Tinkerforge/real-time-clock-bricklet/software/examples/labview/Example Callback.vi.png

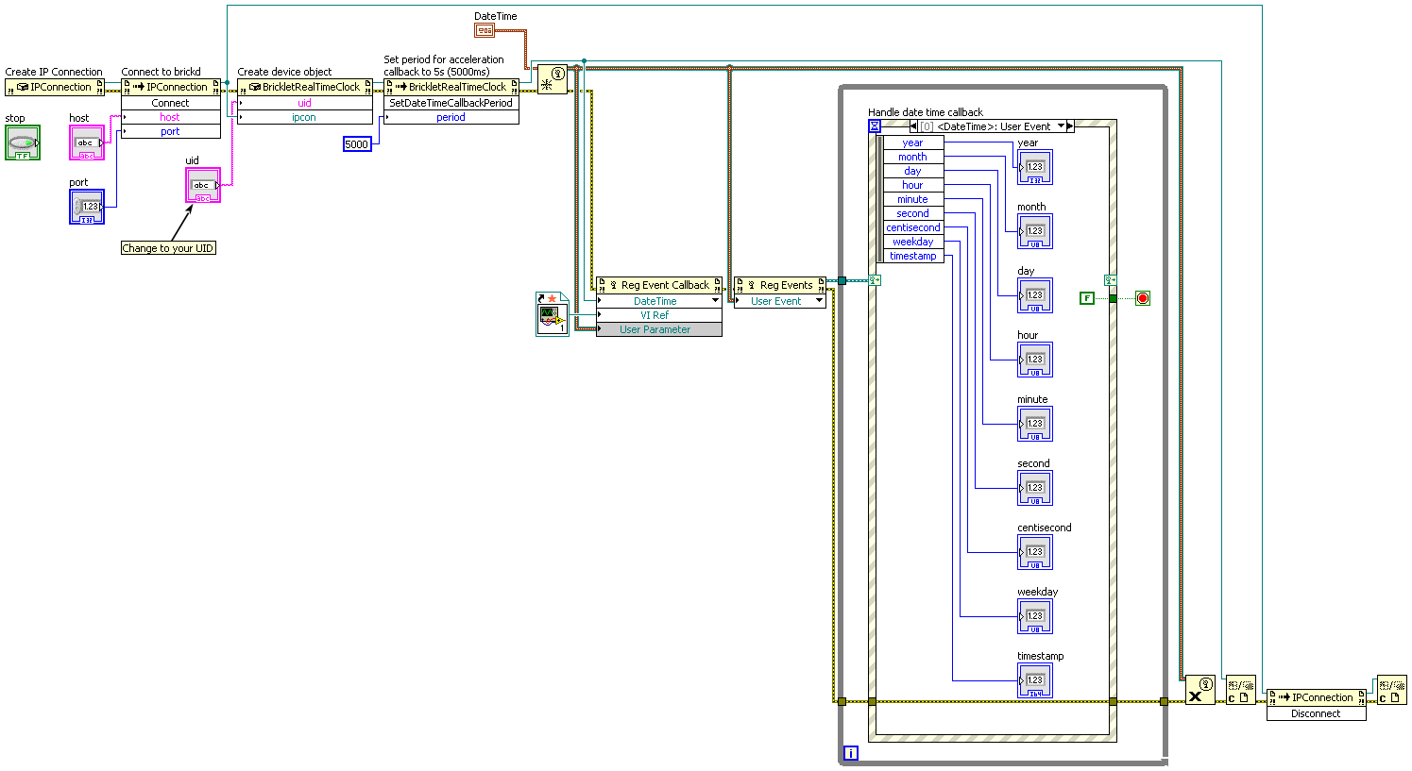
software/examples/labview/Example Callback.vi.png
