Tinkerforge/real-time-clock-bricklet/hardware/real-time-clock.step

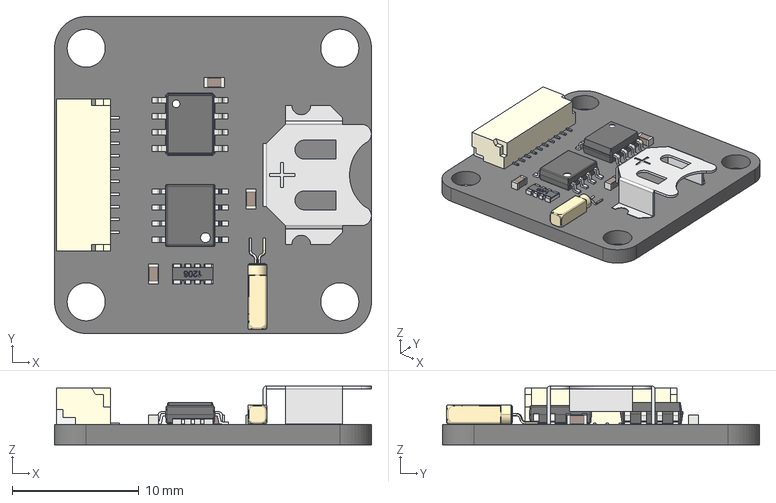
[picture p3: CAD file, 2018-01-30]
hardware/real-time-clock.step
25.0 x 25.0 x 4.65 mm
