Tinkerforge/real-time-clock-bricklet/(list of files, cad)

Other CAD files:
hardware/real-time-clock.FCStd
