Tinkerforge/real-time-clock-bricklet/hardware/real-time-clock-schematic.pdf

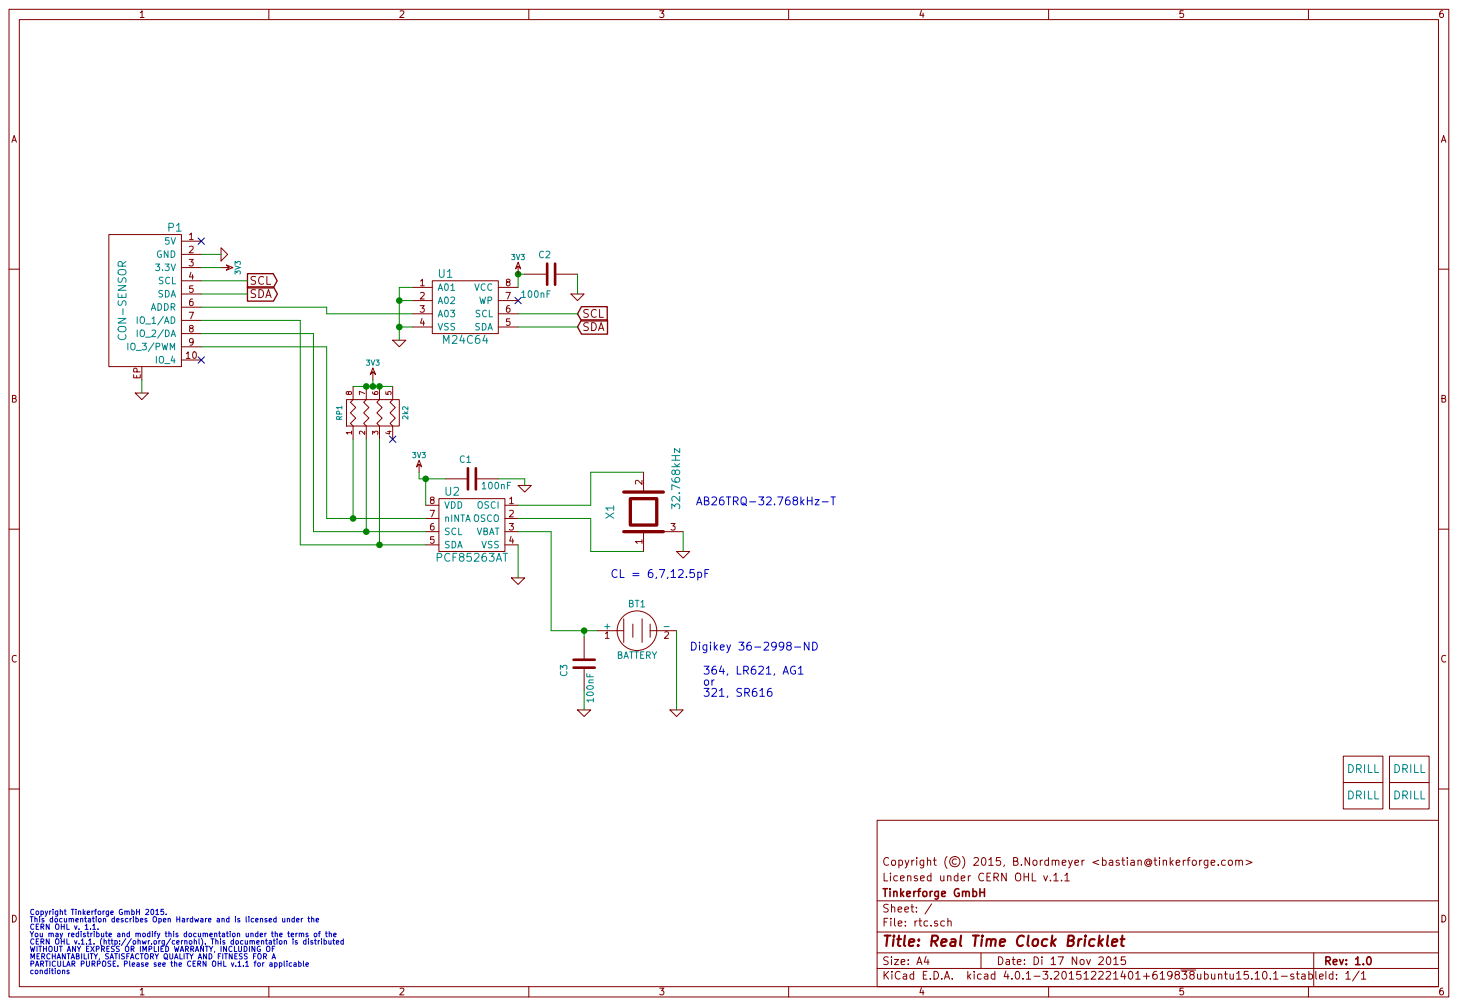
[picture p4: page 1]

Licensed under CERN OHL v.1.1 Copyright (©) 2015, B.Nordmeyer <bastian@tinkerforge.com>

Id: 1/1 Title: Real Time Clock Bricklet File: rtc.sch Sheet: / Tinkerforge GmbH

Copyright Tinkerforge GmbH 2015. This documentation describes Open Hardware and is licensed under the CERN OHL v. 1.1. You may redistribute and modify this documentation under the terms of the CERN OHL v.1.1. (http://ohwr.org/cernohl). This documentation is distributed WITHOUT ANY EXPRESS OR IMPLIED WARRANTY, INCLUDING OF MERCHANTABILITY, SATISFACTORY QUALITY AND FITNESS FOR A

PARTICULAR PURPOSE. Please see the CERN OHL v.1.1 for applicable
