Tinkerforge/real-time-clock-bricklet/hardware/real-time-clock.kicad_pcb

## KiCad design hardware/real-time-clock.kicad_pcb (2018-01-30)

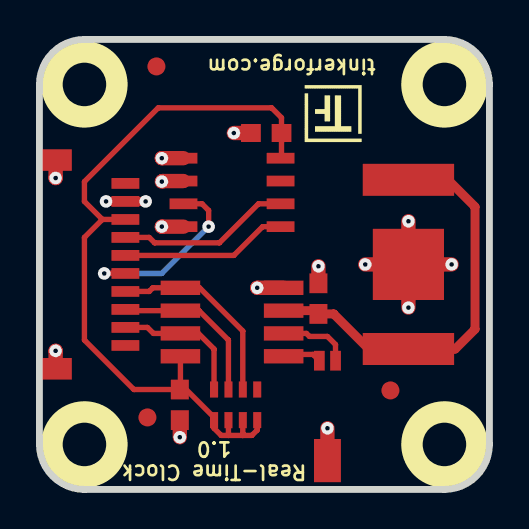
[picture p5: board real-time-clock.kicad_pcb from above]

Board: 2 copper layers, 25.0 x 25.0 mm, 18 parts (0 on the bottom side), 11 nets.

Parts:
BT1: BATTERY; BATTERY_HOLDER_2998
C1, C2, C3: 100nF; C0603E
Fiducial_Mark: VAL**; Fiducial_Mark
Fiducial_Mark#2, Fiducial_Mark#3: VAL**; Fiducial_Mark
P1: CON-SENSOR
RP1: 2k2; 4X0603
U1: M24C64; SOIC8
U2: PCF85263AT; SO-8
U3, U4, U5, U6: DRILL; DRILL_NP
VAL: WEEE_7mm_back
VAL#2: CE_5mm
X1: 32.768kHz; AB26TRQ

Connections:
3V3: C1.1, C2.1, P1.3, RP1.5, RP1.6, RP1.7, RP1.8, U1.8, U2.8
GND: BT1.2, C1.2, C2.2, C3.2, P1.2, P1.EP, U1.1, U1.2, U1.4, U2.4, X1.3
unnamed: BT1.1, C3.1, U2.3
unnamed: P1.6, U1.3
unnamed: P1.7, RP1.3, U2.5
unnamed: P1.8, RP1.2, U2.6
unnamed: P1.9, RP1.1, U2.7
unnamed: U2.1, X1.2
unnamed: U2.2, X1.1
SCL: P1.4, U1.6
SDA: P1.5, U1.5
