Tinkerforge/real-time-clock-bricklet/software/src/real-time-clock.c

/* real-time-clock
 * Copyright (C) 2016 Matthias Bolte <matthias@tinkerforge.com>
 *
 * real-time-clock.c: Implementation of Real Time Clock Bricklet messages
 *
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
 * You should have received a copy of the GNU Lesser General Public
 * License along with this library; if not, write to the
 * Free Software Foundation, Inc., 59 Temple Place - Suite 330,
 * Boston, MA 02111-1307, USA.
 */

#include "real-time-clock.h"

#include "brickletlib/bricklet_entry.h"
#include "bricklib/bricklet/bricklet_communication.h"
#include "config.h"
#include "bricklib/utility/util_definitions.h"

#define I2C_ADDRESS 0x51 // 0b1010001, I2C address of PCF85263A
#define I2C_HALF_CLOCK_400KHZ 1250 // 2500ns per clock
#define I2C_READ 1
#define I2C_WRITE 0

void invocation(const ComType com, const uint8_t *data) {
	switch(((MessageHeader*)data)->fid) {
		case FID_SET_DATE_TIME:
			set_date_time(com, (SetDateTime*)data);
			return;

		case FID_GET_DATE_TIME:
			get_date_time(com, (GetDateTime*)data);
			return;

		case FID_GET_TIMESTAMP:
			get_timestamp(com, (GetTimestamp*)data);
			return;

		case FID_SET_OFFSET:
			set_offset(com, (SetOffset*)data);
			return;

		case FID_GET_OFFSET:
			get_offset(com, (GetOffset*)data);
			return;

		case FID_SET_DATE_TIME_CALLBACK_PERIOD:
			set_date_time_callback_period(com, (SetDateTimeCallbackPeriod*)data);
			return;

		case FID_GET_DATE_TIME_CALLBACK_PERIOD:
			get_date_time_callback_period(com, (GetDateTimeCallbackPeriod*)data);
			return;

		case FID_SET_ALARM:
			set_alarm(com, (SetAlarm*)data);
			return;

		case FID_GET_ALARM:
			get_alarm(com, (GetAlarm*)data);
			return;

		default:
			BA->com_return_error(data, sizeof(MessageHeader), MESSAGE_ERROR_CODE_NOT_SUPPORTED, com);
			return;
	}
}

void constructor(void) {
	_Static_assert(sizeof(BrickContext) <= BRICKLET_CONTEXT_MAX_SIZE, "BrickContext too big");

	BrickletAPI *ba = BA;
	BrickContext *bc = BC;

	bc->period_date_time = 0;
	bc->period_date_time_counter = 0;
	bc->last_date_time_valid = false;

	bc->flags = 0;
	bc->alarm_enable = 0;
	bc->interval = -1;

	// Setting the interrupt pin as input
	PIN_INT.pio->PIO_PUER = PIN_INT.mask;
	PIN_INT.pio->PIO_ODR = PIN_INT.mask;
	PIN_INT.pio->PIO_PER = PIN_INT.mask;

	// Load calibration from EEPROM
	ba->bricklet_select(BS->port - 'a');

	ba->i2c_eeprom_master_read(ba->twid->pTwi,
	                           CALIBRATION_EEPROM_POSITION,
	                           (char *)bc->calibration,
	                           sizeof(bc->calibration));

	if (bc->calibration[0] == CALIBRATION_EEPROM_MAGIC0 &&
	    bc->calibration[1] == CALIBRATION_EEPROM_MAGIC1) {
		write_register(REG_OFFSET, bc->calibration[2]);
	} else {
		// EEPROM doesn't contain calibration, store current calibration
		bc->calibration[0] = CALIBRATION_EEPROM_MAGIC0;
		bc->calibration[1] = CALIBRATION_EEPROM_MAGIC1;
		bc->calibration[2] = read_register(REG_OFFSET);

		ba->i2c_eeprom_master_write(ba->twid->pTwi,
		                            CALIBRATION_EEPROM_POSITION,
		                            (const char*)bc->calibration,
		                            sizeof(bc->calibration));
	}

	ba->bricklet_deselect(BS->port - 'a');

	// Select 12.5pF oscillator load capacitance
	write_register(REG_OSCILLATOR, REG_OSCILLATOR_CL_12PF);

	// Enable 100th second and set CLK pin frequency to 0Hz
	write_register(REG_FUNCTION, REG_FUNCTION_100TH_ENABLED | REG_FUNCTION_COF_STATIC_LOW);

	// Disable CLK pin and enable nINTA output pin
	write_register(REG_PIN_IO, REG_PIN_IO_CLKPM_DISABLE | REG_PIN_IO_INTAPM_INTA);

	// Enable nINTA interrupts
	write_register(REG_INTA_ENABLE, REG_INTA_ENABLE_ALARM1 | REG_INTA_ENABLE_ALARM2 | REG_INTA_ENABLE_LEVEL_MODE);
}

void destructor(void) {
}

void tick(const uint8_t tick_type) {
	BrickletAPI *ba = BA;
	BrickContext *bc = BC;
	uint32_t uid = BS->uid;

	if (tick_type & TICK_TASK_TYPE_CALCULATION) {
		if (!(PIN_INT.pio->PIO_PDSR & PIN_INT.mask)) { // nINTA
			bc->flags = read_register(REG_FLAGS);
			bc->alarm_enable = read_register(REG_RTC_ALARM_ENABLE);
			write_register(REG_FLAGS, 0);
		}

		if (bc->period_date_time_counter != 0) {
			bc->period_date_time_counter--;
		}
	}

	if (tick_type & TICK_TASK_TYPE_MESSAGE) {
		if (bc->period_date_time != 0 && bc->period_date_time_counter == 0) {
			DateTime dt;
			ba->com_make_default_header(&dt, uid, sizeof(dt), FID_DATE_TIME);

			uint64_t registers_merged = read_date_time(&dt.fields);

			if (!bc->last_date_time_valid || bc->last_date_time_merged != registers_merged) {
				dt.timestamp = calculate_timestamp(&dt.fields);

				ba->send_blocking_with_timeout(&dt, sizeof(dt), *ba->com_current);

				bc->period_date_time_counter = bc->period_date_time;

				bc->last_date_time_valid = true;
				bc->last_date_time_merged = registers_merged;
			}
		}

		if (bc->flags & (REG_FLAGS_ALARM1 | REG_FLAGS_ALARM2)) {
			uint8_t expected = 0;
			uint8_t found = 0;

			if (bc->alarm_enable & REG_RTC_ALARM_ENABLE_A1E_mask) {
				++expected;

				if (bc->flags & REG_FLAGS_ALARM1) {
					++found;
				}
			}

			if (bc->alarm_enable & REG_RTC_ALARM_ENABLE_A2E_mask) {
				++expected;

				if (bc->flags & REG_FLAGS_ALARM2) {
					++found;
				}
			}

			bool triggered = false;

			if (expected > 0) {
				if (expected == found) {
					triggered = true;
				} else if (expected == 2 && (bc->flags & REG_FLAGS_ALARM1)) {
					// Special case: weekday + other fields are enabled and the
					// other fields have triggered, but the weekday had already
					// triggered before or not at all. Manually check if the
					// weekday still matches to manually trigger the alarm.
					uint8_t alarm_weekday = read_register(REG_RTC_ALARM2_WEEKDAY);
					uint8_t date_weekday = read_register(REG_RTC_DATE_WEEKDAY);

					if (alarm_weekday == date_weekday) {
						triggered = true;
					}
				}
			}

			if (triggered) {
				Alarm a;
				ba->com_make_default_header(&a, uid, sizeof(a), FID_ALARM);

				read_date_time(&a.fields);
				a.timestamp = calculate_timestamp(&a.fields);

				if (bc->interval > 0) {
					DateTimeFields fields = a.fields;
					uint8_t bytes[9];

					// Clear alarm enable bits
					write_register(REG_RTC_ALARM_ENABLE, 0);

					// Calculate new alarm
					if (add_seconds(&fields, bc->interval)) {
						bytes[0] = bin2bcd(fields.second);
						bytes[1] = bin2bcd(fields.minute);
						bytes[2] = bin2bcd(fields.hour);
						bytes[3] = bin2bcd(fields.day);
						bytes[4] = bin2bcd(fields.month);

						bytes[8] = REG_RTC_ALARM_ENABLE_A1E_MONTH |
						           REG_RTC_ALARM_ENABLE_A1E_DAY |
						           REG_RTC_ALARM_ENABLE_A1E_HOUR |
						           REG_RTC_ALARM_ENABLE_A1E_MINUTE |
						           REG_RTC_ALARM_ENABLE_A1E_SECOND;

						// Set alarm and enable bits
						write_registers(REG_RTC_ALARM1_SECOND, bytes, 9);
					}
				}

				ba->send_blocking_with_timeout(&a, sizeof(a), *ba->com_current);
			}

			bc->flags = 0;
			bc->alarm_enable = 0;
		}
	}
}

void set_date_time(const ComType com, const SetDateTime *data) {
	BrickletAPI *ba = BA;

	if (data->year < 2000 || data->year > 2099 ||
	    data->month < 1 || data->month > 12 ||
	    data->day < 1 || data->day > 31 ||
	    data->hour > 23 ||
	    data->minute > 59 ||
	    data->second > 59 ||
	    data->centisecond > 99 ||
	    data->weekday < 1 || data->weekday > 7) {
		ba->com_return_error(data, sizeof(MessageHeader), MESSAGE_ERROR_CODE_INVALID_PARAMETER, com);
		return;
	}

	const uint8_t bytes[8] = {
		bin2bcd(data->centisecond),
		bin2bcd(data->second),
		bin2bcd(data->minute),
		bin2bcd(data->hour),
		bin2bcd(data->day),
		bin2bcd(data->weekday % 7), // Convert from [Mon..Sun] == [1..7] to [Sun..Sat] == [0..6]
		bin2bcd(data->month),
		bin2bcd(data->year - 2000)
	};

	// Stop clock and clear prescaler
	write_register(REG_STOP_ENABLE, REG_STOP_ENABLE_STOP_ENABLED);
	write_register(REG_RESET, REG_RESET_CLEAR_PRESCALER);

	// Set clock
	write_registers(REG_RTC_TIME_100TH_SECOND, bytes, 8);

	// Start clock
	write_register(REG_STOP_ENABLE, REG_STOP_ENABLE_STOP_DISABLED);

	ba->com_return_setter(com, data);
}

void get_date_time(const ComType com, const GetDateTime *data) {
	GetDateTimeReturn gdtr;

	gdtr.header        = data->header;
	gdtr.header.length = sizeof(gdtr);

	read_date_time(&gdtr.fields);

	BA->send_blocking_with_timeout(&gdtr, sizeof(gdtr), com);
}

void get_timestamp(const ComType com, const GetTimestamp *data) {
	GetTimestampReturn gtr;
	DateTimeFields fields;

	gtr.header        = data->header;
	gtr.header.length = sizeof(gtr);

	read_date_time(&fields);

	gtr.timestamp     = calculate_timestamp(&fields);

	BA->send_blocking_with_timeout(&gtr, sizeof(gtr), com);
}

void set_offset(const ComType com, const SetOffset *data) {
	BrickletAPI *ba = BA;
	BrickContext *bc = BC;

	bc->calibration[2] = data->offset;

	write_register(REG_OFFSET, bc->calibration[2]);

	ba->bricklet_select(BS->port - 'a');
	ba->i2c_eeprom_master_write(ba->twid->pTwi,
	                            CALIBRATION_EEPROM_POSITION,
	                            (const char*)bc->calibration,
	                            sizeof(bc->calibration));
	ba->bricklet_deselect(BS->port - 'a');

	ba->com_return_setter(com, data);
}

void get_offset(const ComType com, const GetOffset *data) {
	GetOffsetReturn gor;

	gor.header        = data->header;
	gor.header.length = sizeof(gor);
	gor.offset        = BC->calibration[2];

	BA->send_blocking_with_timeout(&gor, sizeof(gor), com);
}

void set_date_time_callback_period(const ComType com, const SetDateTimeCallbackPeriod *data) {
	BC->period_date_time = data->period;

	BA->com_return_setter(com, data);
}

void get_date_time_callback_period(const ComType com, const GetDateTimeCallbackPeriod *data) {
	GetDateTimeCallbackPeriodReturn gdtcpr;

	gdtcpr.header         = data->header;
	gdtcpr.header.length  = sizeof(gdtcpr);
	gdtcpr.period         = BC->period_date_time;

	BA->send_blocking_with_timeout(&gdtcpr, sizeof(gdtcpr), com);
}

void set_alarm(const ComType com, const SetAlarm *data) {
	BrickletAPI *ba = BA;

#if 0
	// FIXME: this would be the classic way of parameter checking, but with
	//        this GCC misscompiles the code. therefore, parameter checking is
	//        integrated with the parameter translation
	if ((data->month != -1 && (data->month < 1 || data->month > 12)) ||
	    (data->day != -1 && (data->day < 1 || data->day > 31)) ||
	    (data->hour != -1 && (data->hour < 0 || data->hour > 23)) ||
	    (data->minute != -1 && (data->minute < 0 || data->minute > 59)) ||
	    (data->second != -1 && (data->second < 0 || data->second > 59)) ||
	    (data->weekday != -1 && (data->weekday < 1 || data->weekday > 7)) ||
	    (data->interval != -1 && data->interval == 0) {
		ba->com_return_error(data, sizeof(MessageHeader), MESSAGE_ERROR_CODE_INVALID_PARAMETER, com);
		return;
	}
#endif

	// Prepare alarm register values
	uint8_t bytes[9] = {0};
	bool invalid = false;

	if (data->second >= 0 && data->second <= 59) {
		bytes[0] = bin2bcd(data->second);
		bytes[8] |= REG_RTC_ALARM_ENABLE_A1E_SECOND;
	} else if (data->second != -1) {
		invalid = true;
	}

	if (data->minute >= 0 && data->minute <= 59) {
		bytes[1] = bin2bcd(data->minute);
		bytes[8] |= REG_RTC_ALARM_ENABLE_A1E_MINUTE;
	} else if (data->minute != -1) {
		invalid = true;
	}

	if (data->hour >= 0 && data->hour <= 23) {
		bytes[2] = bin2bcd(data->hour);
		bytes[8] |= REG_RTC_ALARM_ENABLE_A1E_HOUR;
	} else if (data->hour != -1) {
		invalid = true;
	}

	if (data->day >= 1 && data->day <= 31) {
		bytes[3] = bin2bcd(data->day);
		bytes[8] |= REG_RTC_ALARM_ENABLE_A1E_DAY;
	} else if (data->day != -1) {
		invalid = true;
	}

	if (data->month >= 1 && data->month <= 12) {
		bytes[4] = bin2bcd(data->month);
		bytes[8] |= REG_RTC_ALARM_ENABLE_A1E_MONTH;
	} else if (data->month != -1) {
		invalid = true;
	}

	if (data->weekday >= 1 && data->weekday <= 7) {
		bytes[7] = bin2bcd(data->weekday % 7), // Convert from [Mon..Sun] == [1..7] to [Sun..Sat] == [0..6]
		bytes[8] |= REG_RTC_ALARM_ENABLE_A2E_WEEKDAY;
	} else if (data->weekday != -1) {
		invalid = true;
	}

	if (data->interval == 0 || data->interval < -1) {
		invalid = true;
	}

	if (invalid) {
		ba->com_return_error(data, sizeof(MessageHeader), MESSAGE_ERROR_CODE_INVALID_PARAMETER, com);
		return;
	}

	BC->interval = data->interval;

	if (bytes[8] == 0 && data->interval > 0) {
		DateTimeFields fields;

		read_date_time(&fields);

		if (add_seconds(&fields, data->interval)) {
			bytes[0] = bin2bcd(fields.second);
			bytes[1] = bin2bcd(fields.minute);
			bytes[2] = bin2bcd(fields.hour);
			bytes[3] = bin2bcd(fields.day);
			bytes[4] = bin2bcd(fields.month);

			bytes[8] = REG_RTC_ALARM_ENABLE_A1E_MONTH |
			           REG_RTC_ALARM_ENABLE_A1E_DAY |
			           REG_RTC_ALARM_ENABLE_A1E_HOUR |
			           REG_RTC_ALARM_ENABLE_A1E_MINUTE |
			           REG_RTC_ALARM_ENABLE_A1E_SECOND;
		} else {
			bytes[8] = 0;
		}
	}

	// Clear alarm enable bits
	write_register(REG_RTC_ALARM_ENABLE, 0);

	// Clear alarm interrupt flags
	write_register(REG_FLAGS, 0);

	// Set alarm and enable bits
	if (bytes[8] != 0) {
		write_registers(REG_RTC_ALARM1_SECOND, bytes, 9);
	}

	ba->com_return_setter(com, data);
}

void get_alarm(const ComType com, const GetAlarm *data) {
	GetAlarmReturn gar;
	uint8_t bytes[9];

	gar.header         = data->header;
	gar.header.length  = sizeof(gar);

	read_registers(REG_RTC_ALARM1_SECOND, bytes, 9);

	if (bytes[8] & REG_RTC_ALARM_ENABLE_A1E_MONTH) {
		gar.month = bcd2bin(bytes[4]);
	} else {
		gar.month = -1;
	}

	if (bytes[8] & REG_RTC_ALARM_ENABLE_A1E_DAY) {
		gar.day = bcd2bin(bytes[3]);
	} else {
		gar.day = -1;
	}

	if (bytes[8] & REG_RTC_ALARM_ENABLE_A1E_HOUR) {
		gar.hour = bcd2bin(bytes[2]);
	} else {
		gar.hour = -1;
	}

	if (bytes[8] & REG_RTC_ALARM_ENABLE_A1E_MINUTE) {
		gar.minute = bcd2bin(bytes[1]);
	} else {
		gar.minute = -1;
	}

	if (bytes[8] & REG_RTC_ALARM_ENABLE_A1E_SECOND) {
		gar.second = bcd2bin(bytes[0]);
	} else {
		gar.second = -1;
	}

	if (bytes[8] & REG_RTC_ALARM_ENABLE_A2E_WEEKDAY) {
		gar.weekday = bcd2bin(bytes[7]);

		// Convert from [Sun..Sat] == [0..6] to [Mon..Sun] == [1..7]
		if (gar.weekday == 0) {
			gar.weekday = 7;
		}
	} else {
		gar.weekday = -1;
	}

	gar.interval = BC->interval;

	BA->send_blocking_with_timeout(&gar, sizeof(gar), com);
}

uint8_t read_register(const uint8_t reg) {
	i2c_start();
	i2c_send_byte((I2C_ADDRESS << 1) | I2C_WRITE);
	i2c_send_byte(reg);
	i2c_stop();
	i2c_start();
	i2c_send_byte((I2C_ADDRESS << 1) | I2C_READ);

	uint8_t value = i2c_recv_byte(false);

	i2c_stop();

	return value;
}

void read_registers(const uint8_t reg, uint8_t *data, const uint8_t length) {
	i2c_start();
	i2c_send_byte((I2C_ADDRESS << 1) | I2C_WRITE);
	i2c_send_byte(reg);
	i2c_stop();
	i2c_start();
	i2c_send_byte((I2C_ADDRESS << 1) | I2C_READ);

	for(uint8_t i = 0; i < length; i++) {
		data[i] = i2c_recv_byte(i != (length - 1));
	}

	i2c_stop();
}

void write_register(const uint8_t reg, const uint8_t value) {
	i2c_start();
	i2c_send_byte((I2C_ADDRESS << 1) | I2C_WRITE);
	i2c_send_byte(reg);
	i2c_send_byte(value);
	i2c_stop();
}

void write_registers(const uint8_t reg, const uint8_t *data, const uint8_t length) {
	i2c_start();
	i2c_send_byte((I2C_ADDRESS << 1) | I2C_WRITE);
	i2c_send_byte(reg);

	for(uint8_t i = 0; i < length; i++) {
		i2c_send_byte(data[i]);
	}

	i2c_stop();
}

uint64_t read_date_time(DateTimeFields *fields) {
	union {
		uint8_t bytes[8];
		uint64_t merged;
	} data;

	read_registers(REG_RTC_TIME_100TH_SECOND, data.bytes, 8);

	data.bytes[2] &= 0b01111111; // remove EMON bit
	data.bytes[1] &= 0b01111111; // remove OS bit

	fields->year        = 2000 + bcd2bin(data.bytes[7]);
	fields->month       = bcd2bin(data.bytes[6]);
	fields->day         = bcd2bin(data.bytes[4]);
	fields->hour        = bcd2bin(data.bytes[3]);
	fields->minute      = bcd2bin(data.bytes[2]);
	fields->second      = bcd2bin(data.bytes[1]);
	fields->centisecond = bcd2bin(data.bytes[0]);
	fields->weekday     = bcd2bin(data.bytes[5]);

	// Convert from [Sun..Sat] == [0..6] to [Mon..Sun] == [1..7]
	if (fields->weekday == 0) {
		fields->weekday = 7;
	}

	return data.merged;
}

static const uint16_t days_before_this_month_table[12] = {
	0,
	31,
	31 + 28,
	31 + 28 + 31,
	31 + 28 + 31 + 30,
	31 + 28 + 31 + 30 + 31,
	31 + 28 + 31 + 30 + 31 + 30,
	31 + 28 + 31 + 30 + 31 + 30 + 31,
	31 + 28 + 31 + 30 + 31 + 30 + 31 + 31,
	31 + 28 + 31 + 30 + 31 + 30 + 31 + 31 + 30,
	31 + 28 + 31 + 30 + 31 + 30 + 31 + 31 + 30 + 31,
	31 + 28 + 31 + 30 + 31 + 30 + 31 + 31 + 30 + 31 + 30
};

int64_t calculate_timestamp(DateTimeFields *fields) {
	uint8_t year = fields->year - 2000;
	int64_t days_before_this_year = year * 365 + (MAX((int8_t)year - 1, 0)) / 4 + (year > 0 ? 1 : 0);
	int64_t days_before_this_month = days_before_this_month_table[fields->month - 1] + (fields->month > 2 && year % 4 == 0 ? 1 : 0);

	return (((((days_before_this_year + days_before_this_month + fields->day - 1) * 24 + fields->hour) * 60 + fields->minute) * 60) + fields->second) * 1000 + fields->centisecond * 10;
}

static const uint8_t days_in_this_month_table[12] = {
	31,
	28,
	31,
	30,
	31,
	30,
	31,
	31,
	30,
	31,
	30,
	31
};

bool add_seconds(DateTimeFields *fields, int32_t seconds) {
	fields->second += seconds % 60;

	if (fields->second > 59) {
		fields->second -= 60;
		++fields->minute;
	}

	int32_t minutes = seconds / 60;
	fields->minute += minutes % 60;

	if (fields->minute > 59) {
		fields->minute -= 60;
		++fields->hour;
	}

	int32_t hours = minutes / 60;
	fields->hour += hours % 24;

	if (fields->hour > 23) {
		fields->hour -= 24;
		++fields->day;
	}

	int32_t days = hours / 24;
	uint8_t days_in_this_month = days_in_this_month_table[fields->month - 1];

	if (fields->month == 2 && fields->year % 4 == 0) {
		++days_in_this_month;
	}

	while (fields->day + days > days_in_this_month) {
		days -= days_in_this_month - fields->day + 1;

		fields->day = 1;
		++fields->month;

		if (fields->month == 13) {
			fields->month = 1;

			if (fields->year == 2099) {
				return false;
			}

			++fields->year;
		}

		days_in_this_month = days_in_this_month_table[fields->month - 1];

		if (fields->month == 2 && fields->year % 4 == 0) {
			++days_in_this_month;
		}
	}

	fields->day += days;

	return true;
}

bool i2c_scl_value(void) {
	return PIN_SCL.pio->PIO_PDSR & PIN_SCL.mask;
}

void i2c_scl_high(void) {
	PIN_SCL.pio->PIO_ODR = PIN_SCL.mask;
	while(!i2c_scl_value()); // allow slave to clock-stretch
}

void i2c_scl_low(void) {
	PIN_SCL.pio->PIO_OER = PIN_SCL.mask;
}

bool i2c_sda_value(void) {
	return PIN_SDA.pio->PIO_PDSR & PIN_SDA.mask;
}

void i2c_sda_high(void) {
	PIN_SDA.pio->PIO_ODR = PIN_SDA.mask;
}

void i2c_sda_low(void) {
	PIN_SDA.pio->PIO_OER = PIN_SDA.mask;
}

void i2c_sleep_halfclock(void) {
	SLEEP_NS(I2C_HALF_CLOCK_400KHZ);
}

void i2c_stop(void) {
	i2c_scl_low();
	i2c_sda_low();
	i2c_sleep_halfclock();
	i2c_scl_high();
	i2c_sleep_halfclock();
	i2c_sda_high();
	i2c_sleep_halfclock();
}

void i2c_start(void) {
	i2c_scl_high();
	i2c_sleep_halfclock();
	i2c_sda_low();
	i2c_sleep_halfclock();
}

uint8_t i2c_recv_byte(bool ack) {
	uint8_t value = 0;

	for(int8_t i = 7; i >= 0; i--) {
		i2c_scl_low();
		i2c_sda_high(); // allow slave to read
		i2c_sleep_halfclock();
		i2c_scl_high();

		if(i2c_sda_value()) {
			value |= (1 << i);
		}

		i2c_sleep_halfclock();
	}

	// ACK
	i2c_scl_low();

	if(ack) {
		i2c_sda_low();
	} else {
		i2c_sda_high();
	}

	i2c_sleep_halfclock();
	i2c_scl_high();
	i2c_sleep_halfclock();

	return value;
}

bool i2c_send_byte(const uint8_t value) {
	for(int8_t i = 7; i >= 0; i--) {
		i2c_scl_low();

		if((value >> i) & 1) {
			i2c_sda_high();
		} else {
			i2c_sda_low();
		}

		i2c_sleep_halfclock();
		i2c_scl_high();
		i2c_sleep_halfclock();
	}

	// Wait for ACK
	bool ret = false;

	i2c_scl_low();
	i2c_sleep_halfclock();
	i2c_scl_high();

	if(!i2c_sda_value()) {
		ret = true;
	}

	i2c_sleep_halfclock();

	return ret;
}

uint8_t bcd2bin(const uint8_t bcd) {
	return (bcd >> 4) * 10 + (bcd & 0b00001111);
}

uint8_t bin2bcd(const uint8_t bin) {
	return ((bin / 10) << 4) + (bin % 10);
}
