Tinkerforge/real-time-clock-bricklet/software/src/real-time-clock.h

/* real-time-clock
 * Copyright (C) 2016 Matthias Bolte <matthias@tinkerforge.com>
 *
 * real-time-clock.h: Implementation of Real Time Clock Bricklet messages
 *
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
 * You should have received a copy of the GNU Lesser General Public
 * License along with this library; if not, write to the
 * Free Software Foundation, Inc., 59 Temple Place - Suite 330,
 * Boston, MA 02111-1307, USA.
 */

#ifndef REAL_TIME_CLOCK_H
#define REAL_TIME_CLOCK_H

#include <stdint.h>
#include "bricklib/com/com_common.h"

#define CALIBRATION_EEPROM_POSITION (BRICKLET_PLUGIN_MAX_SIZE + 96)
#define CALIBRATION_EEPROM_MAGIC0   0b00110011
#define CALIBRATION_EEPROM_MAGIC1   0b10101010

#define FID_SET_DATE_TIME 1
#define FID_GET_DATE_TIME 2
#define FID_GET_TIMESTAMP 3
#define FID_SET_OFFSET 4
#define FID_GET_OFFSET 5
#define FID_SET_DATE_TIME_CALLBACK_PERIOD 6
#define FID_GET_DATE_TIME_CALLBACK_PERIOD 7
#define FID_SET_ALARM 8
#define FID_GET_ALARM 9
#define FID_DATE_TIME 10
#define FID_ALARM 11

typedef struct {
	uint16_t year;
	uint8_t month;
	uint8_t day;
	uint8_t hour;
	uint8_t minute;
	uint8_t second;
	uint8_t centisecond;
	uint8_t weekday;
} __attribute__((__packed__)) DateTimeFields;

typedef struct {
	MessageHeader header;
} __attribute__((__packed__)) StandardMessage;

typedef struct {
	MessageHeader header;
	uint16_t year;
	uint8_t month;
	uint8_t day;
	uint8_t hour;
	uint8_t minute;
	uint8_t second;
	uint8_t centisecond;
	uint8_t weekday;
} __attribute__((__packed__)) SetDateTime;

typedef struct {
	MessageHeader header;
} __attribute__((__packed__)) GetDateTime;

typedef struct {
	MessageHeader header;
	DateTimeFields fields;
} __attribute__((__packed__)) GetDateTimeReturn;

typedef struct {
	MessageHeader header;
} __attribute__((__packed__)) GetTimestamp;

typedef struct {
	MessageHeader header;
	int64_t timestamp;
} __attribute__((__packed__)) GetTimestampReturn;

typedef struct {
	MessageHeader header;
	int8_t offset;
} __attribute__((__packed__)) SetOffset;

typedef struct {
	MessageHeader header;
} __attribute__((__packed__)) GetOffset;

typedef struct {
	MessageHeader header;
	int8_t offset;
} __attribute__((__packed__)) GetOffsetReturn;

typedef struct {
	MessageHeader header;
	uint32_t period;
} __attribute__((__packed__)) SetDateTimeCallbackPeriod;

typedef struct {
	MessageHeader header;
} __attribute__((__packed__)) GetDateTimeCallbackPeriod;

typedef struct {
	MessageHeader header;
	uint32_t period;
} __attribute__((__packed__)) GetDateTimeCallbackPeriodReturn;

typedef struct {
	MessageHeader header;
	int8_t month;
	int8_t day;
	int8_t hour;
	int8_t minute;
	int8_t second;
	int8_t weekday;
	int32_t interval; // in seconds
} __attribute__((__packed__)) SetAlarm;

typedef struct {
	MessageHeader header;
} __attribute__((__packed__)) GetAlarm;

typedef struct {
	MessageHeader header;
	int8_t month;
	int8_t day;
	int8_t hour;
	int8_t minute;
	int8_t second;
	int8_t weekday;
	int32_t interval; // in seconds
} __attribute__((__packed__)) GetAlarmReturn;

typedef struct {
	MessageHeader header;
	DateTimeFields fields;
	int64_t timestamp;
} __attribute__((__packed__)) DateTime;

typedef struct {
	MessageHeader header;
	DateTimeFields fields;
	int64_t timestamp;
} __attribute__((__packed__)) Alarm;

void invocation(const ComType com, const uint8_t *data);
void constructor(void);
void destructor(void);
void tick(const uint8_t tick_type);

void set_date_time(const ComType com, const SetDateTime *data);
void get_date_time(const ComType com, const GetDateTime *data);

void get_timestamp(const ComType com, const GetTimestamp *data);

void set_offset(const ComType com, const SetOffset *data);
void get_offset(const ComType com, const GetOffset *data);

void set_date_time_callback_period(const ComType com, const SetDateTimeCallbackPeriod *data);
void get_date_time_callback_period(const ComType com, const GetDateTimeCallbackPeriod *data);

void set_alarm(const ComType com, const SetAlarm *data);
void get_alarm(const ComType com, const GetAlarm *data);

uint8_t read_register(const uint8_t reg);
void read_registers(const uint8_t reg, uint8_t *data, const uint8_t length);
void write_register(const uint8_t reg, const uint8_t value);
void write_registers(const uint8_t reg, const uint8_t *data, const uint8_t length);

uint64_t read_date_time(DateTimeFields *fields);
int64_t calculate_timestamp(DateTimeFields *fields);
bool add_seconds(DateTimeFields *fields, int32_t seconds);

bool i2c_scl_value(void);
void i2c_scl_high(void);
void i2c_scl_low(void);
bool i2c_sda_value(void);
void i2c_sda_high(void);
void i2c_sda_low(void);
void i2c_sleep_halfclock(void);
void i2c_stop(void);
void i2c_start(void);
uint8_t i2c_recv_byte(bool ack);
bool i2c_send_byte(const uint8_t value);

uint8_t bcd2bin(const uint8_t bcd);
uint8_t bin2bcd(const uint8_t bin);

#endif
