Tinkerforge/real-time-clock-bricklet/(commit log)

2015-11-11 initial commit, hardware files copied of can bricklet, schematic partially adapted
    [rtc.kicad_pcb, rtc.sch]
2015-11-17 fully routed
    [rtc.kicad_pcb, rtc.sch]
2015-11-17 fix description
    [rtc.kicad_pcb, rtc.sch]
2016-01-22 Reorder calibration bytes to start with the magic number
2016-01-26 Write user-data to correct register
    [real-time-clock.c]
2016-01-28 Remove fast offset correction mode
    This mdoe is not usefull as the user cannot measure the offset fast
    enough to make use of the fast mode for temperature compensation.
    [real-time-clock.c, real-time-clock.h]
2016-02-01 c: Fix int64_t printf format warning
2016-02-01 change rtc battery footprint
    [rtc.kicad_pcb, rtc.sch]
2016-02-01 add fiducials
    [rtc.kicad_pcb]
2016-02-10 schematic file
2016-02-10 Simplify I2C code
2016-03-30 Restore calibration correctly after reset
    [real-time-clock.c]
2016-05-18 c: Add missing device destroy call
2018-01-22 Add 3d information (tbc)
    [rtc.kicad_pcb, rtc.sch]
2018-01-26 c: Fine-tune printf format
2018-01-30 Add 3d information (final)
    [rtc.kicad_pcb]
2018-01-30 Add 3d model (*.step & *.FCStd)
    [rtc.FCStd, rtc.step]
2018-02-20 Cleanup KiCad libraries config
    Ensure LibDir=kicad-libraries and LibName1=tinkerforge.
    Remove special library.
2018-05-11 Rename files
    [real-time-clock.FCStd, real-time-clock.kicad_pcb, real-time-clock.sch, real-time-clock.step]
2021-10-25 Update KiCad link
    https://www.kicad.org/blog/2021/10/Avoid-links-to-former-kicad-domain/
